AtomicRoland/AtomWifi/doc/Atom 1MHz Bus Schema.pdf

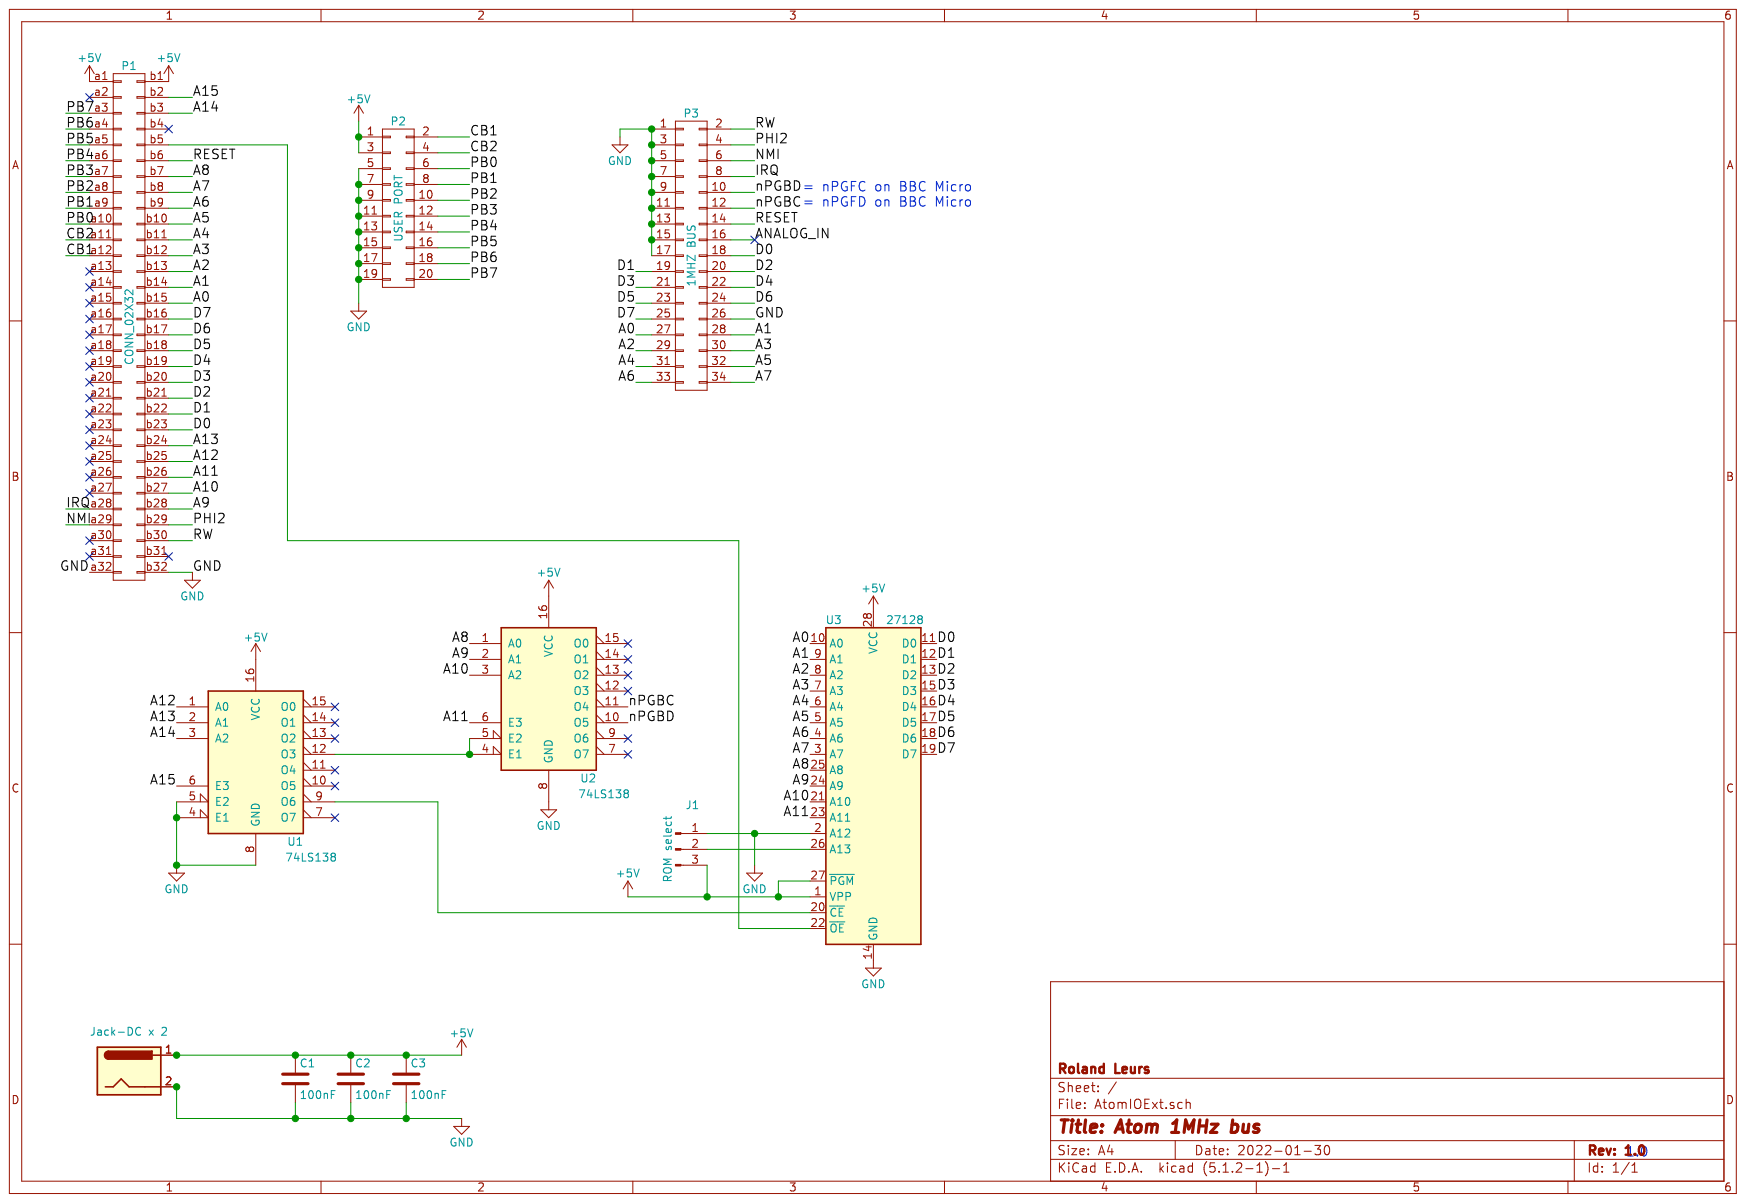
[picture p11: page 1]
