AtomicRoland/AtomWifi/kicad/AtomIOExt.kicad_pcb

## KiCad design kicad/AtomIOExt.kicad_pcb (2022-04-23)

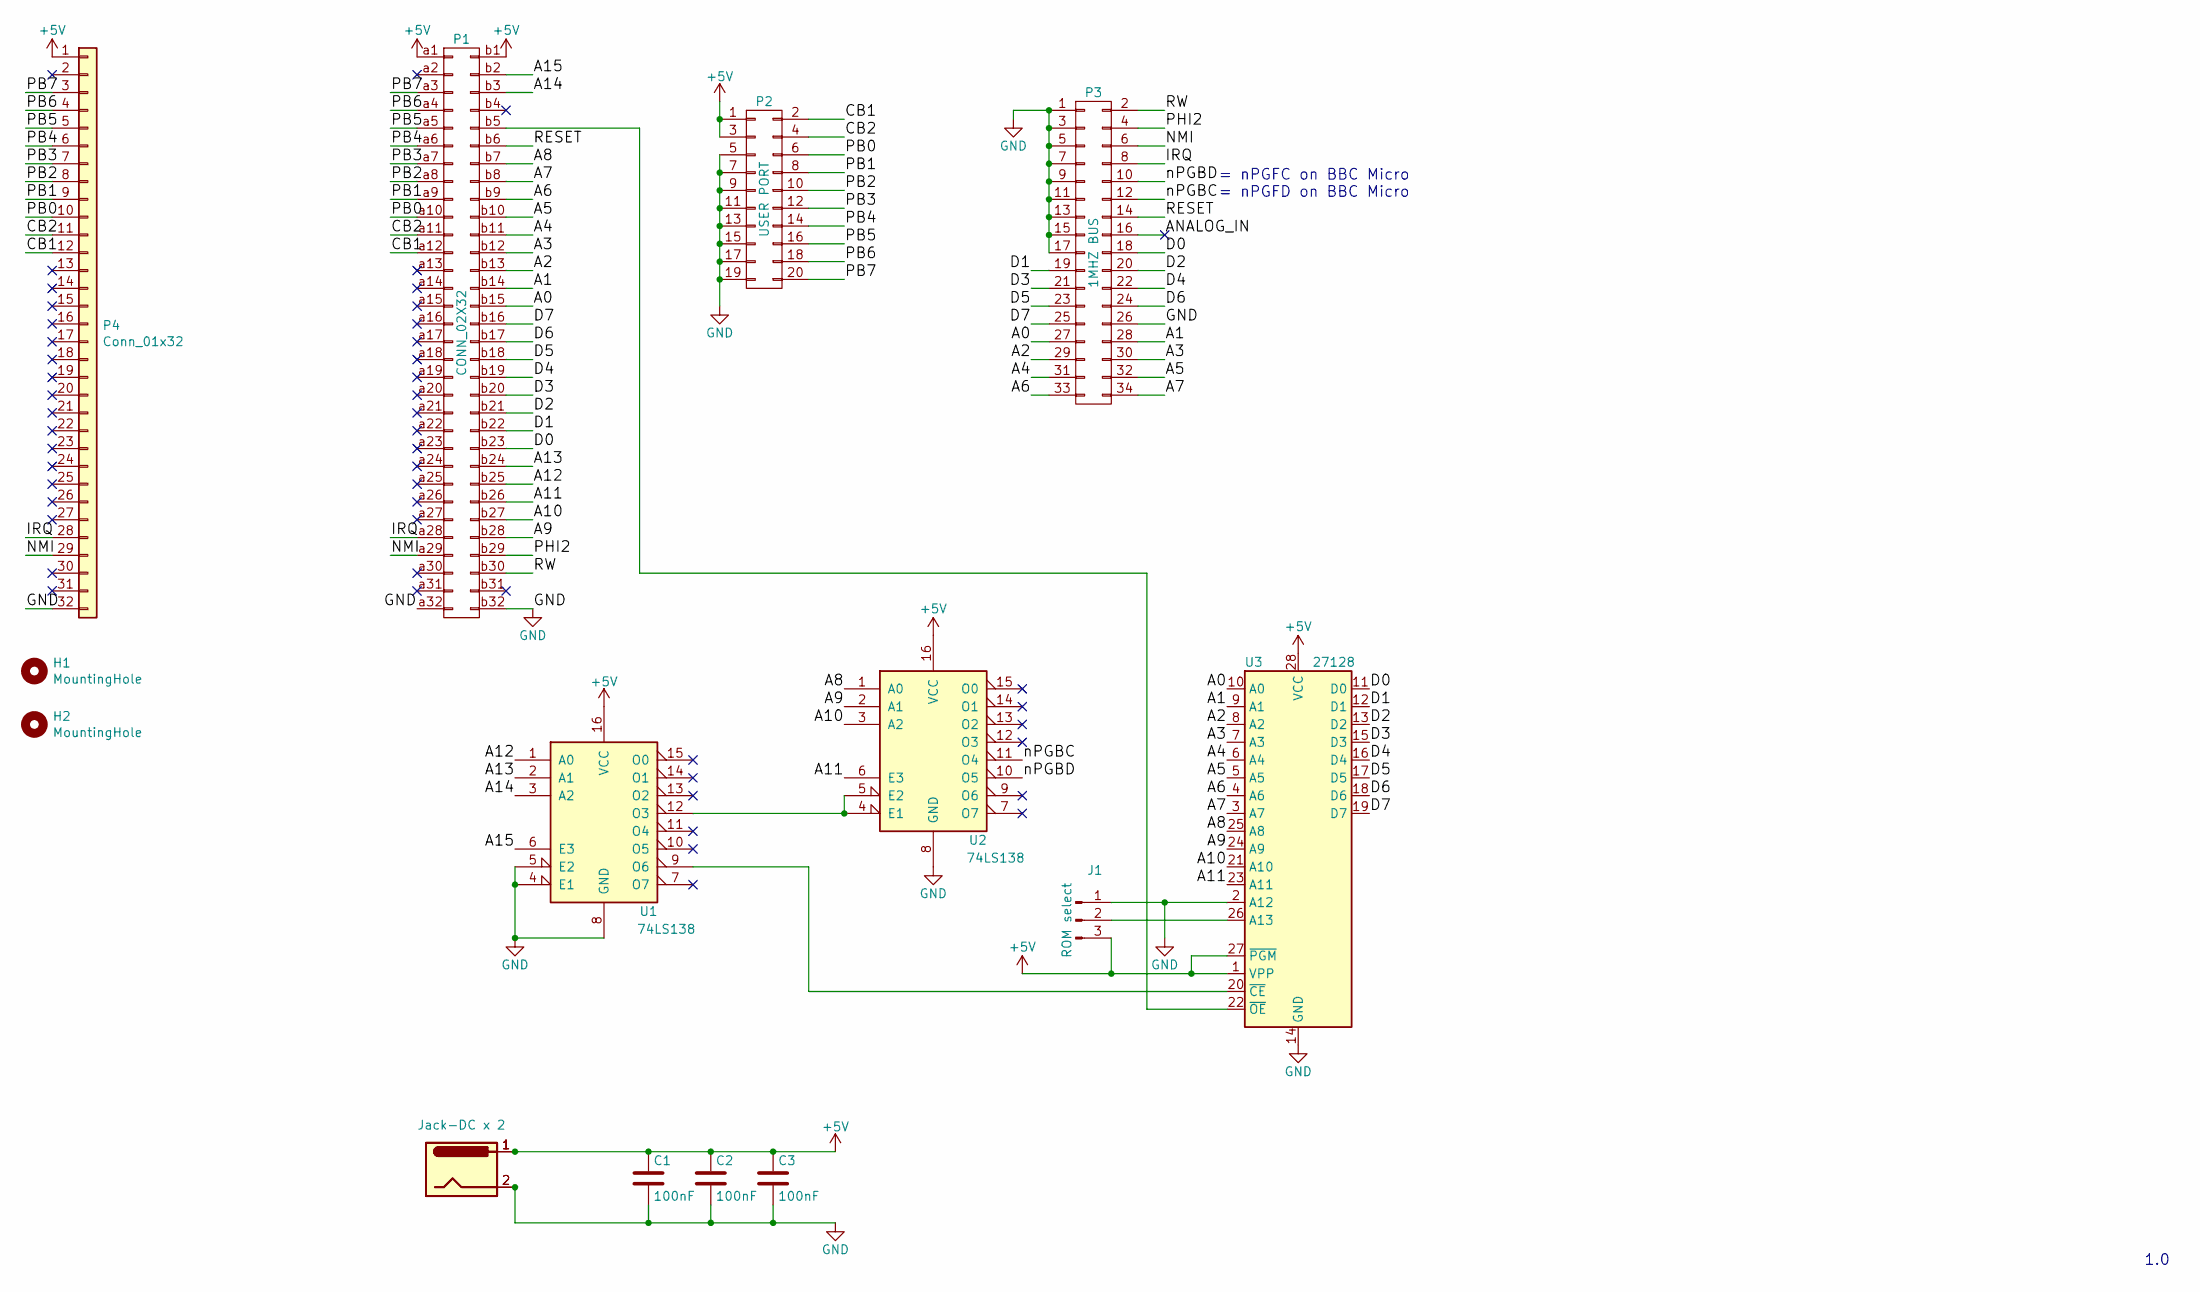
[picture p12: schematic AtomIOExt.sch, Atom 1MHz bus]

Parts:
C1, C2, C3: 100nF; C_Disc_D5.0mm_W2.5mm_P5.00mm
H1, H2: MountingHole; MountingHole_4.3mm_M4
J1: ROM select; PinHeader_1x03_P2.54mm_Vertical
J9: Jack-DC x 2; BarrelJack_Horizontal
J10: Jack-DC; BarrelJack_Horizontal
P1: CONN_02X32; DIN41612_B_2x32_Horizontal
P2: USER PORT; IDC-Header_2x10_P2.54mm_Vertical
P3: 1MHZ BUS; IDC-Header_2x17_P2.54mm_Vertical
P4: Conn_01x32; PinHeader_1x32_P2.54mm_Vertical
U1, U2: 74LS138; DIP-16_W7.62mm_Socket_LongPads
U3: 27128; DIP-28_W15.24mm

Connections:
+5V: C1.1, C2.1, C3.1, J1.3, J9.1, J10.1, P1.a1, P1.b1, P2.1, P2.3, P4.1, U1.16 (VCC), U2.16 (VCC), U3.1 (VPP), U3.27 (~PGM), U3.28 (VCC)
/A0: P1.b15, P3.27, U3.10 (A0)
/A1: P1.b14, P3.28, U3.9 (A1)
/A2: P1.b13, P3.29, U3.8 (A2)
/A3: P1.b12, P3.30, U3.7 (A3)
/A4: P1.b11, P3.31, U3.6 (A4)
/A5: P1.b10, P3.32, U3.5 (A5)
/A6: P1.b9, P3.33, U3.4 (A6)
/A7: P1.b8, P3.34, U3.3 (A7)
/A8: P1.b7, U2.1 (A0), U3.25 (A8)
/A9: P1.b28, U2.2 (A1), U3.24 (A9)
/A10: P1.b27, U2.3 (A2), U3.21 (A10)
/A11: P1.b26, U2.6 (E3), U3.23 (A11)
/A12: P1.b25, U1.1 (A0)
/A13: P1.b24, U1.2 (A1)
/A14: P1.b3, U1.3 (A2)
/A15: P1.b2, U1.6 (E3)
/CB1: P1.a12, P2.2, P4.12
/CB2: P1.a11, P2.4, P4.11
/D0: P1.b23, P3.18, U3.11 (D0)
/D1: P1.b22, P3.19, U3.12 (D1)
/D2: P1.b21, P3.20, U3.13 (D2)
/D3: P1.b20, P3.21, U3.15 (D3)
/D4: P1.b19, P3.22, U3.16 (D4)
/D5: P1.b18, P3.23, U3.17 (D5)
/D6: P1.b17, P3.24, U3.18 (D6)
/D7: P1.b16, P3.25, U3.19 (D7)
/IRQ: P1.a28, P3.8, P4.28
/NMI: P1.a29, P3.6, P4.29
/PB0: P1.a10, P2.6, P4.10
/PB1: P1.a9, P2.8, P4.9
/PB2: P1.a8, P2.10, P4.8
/PB3: P1.a7, P2.12, P4.7
/PB4: P1.a6, P2.14, P4.6
/PB5: P1.a5, P2.16, P4.5
/PB6: P1.a4, P2.18, P4.4
/PB7: P1.a3, P2.20, P4.3
/PHI2: P1.b29, P3.4
/RESET: P1.b6, P3.14
/RW: P1.b30, P3.2
/nPGBC: P3.12, U2.11 (O4)
/nPGBD: P3.10, U2.10 (O5)
GND: C1.2, C2.2, C3.2, J1.1, J9.2, J10.2, P1.a32, P1.b32, P2.5, P2.7, P2.9, P2.11, P2.13, P2.15, P2.17, P2.19, P3.1, P3.3, P3.5, P3.7, P3.9, P3.11, P3.13, P3.15, P3.17, P3.26, P4.32, U1.4 (E1), U1.5 (E2), U1.8 (GND), U2.8 (GND), U3.2 (A12), U3.14 (GND)
unnamed: J1.2, U3.26 (A13)
unnamed: P1.b5, U3.22 (~OE)
unnamed: U1.9 (O6), U3.20 (~CE)
unnamed: U1.12 (O3), U2.4 (E1), U2.5 (E2)

Notes on the sheet:
1.0
= nPGFC on BBC Micro = nPGFD on BBC Micro

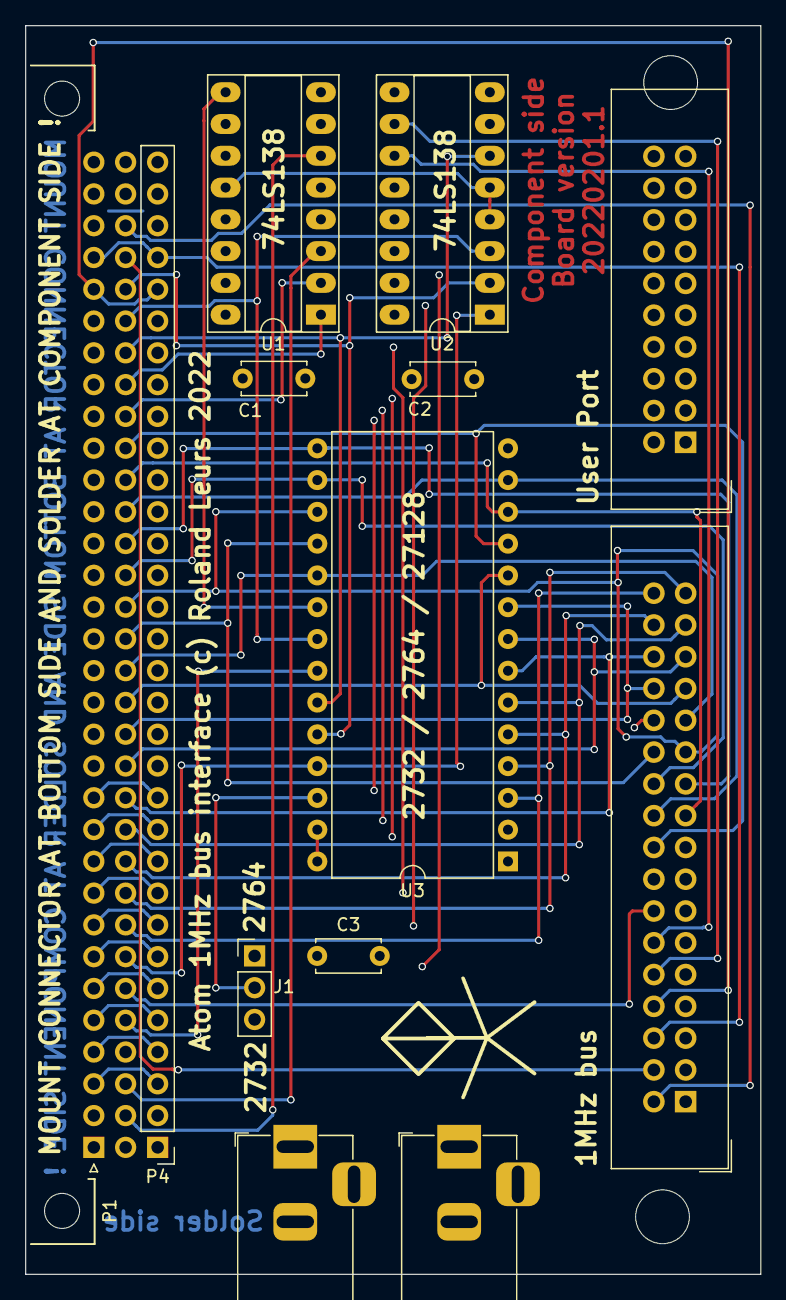
[picture p13: board AtomIOExt.kicad_pcb from above]

Board: 4 copper layers, 58.8 x 99.8 mm, 15 parts (0 on the bottom side), 47 nets.
